UniversalScientificTechnologies/THUNDERMILL01/README.md

# THUNDERMILL01 - Electric field sensor

THUNDERMILL sensor mounted on Lomnický Štít observatory (https://www.youtube.com/watch?v=Zbx8tktlRBg)

THUNDERMILL01 is an open-source [Electric field mill](https://en.wikipedia.org/wiki/Field_mill) sensor for static, portable and airborne measurements. The device is equipped with open-source software that provides high flexibility from the point of view of data output. The sophisticated design of the sensor provides the ability to use the sensor for many applications. The sensor can be operated statically at a fixed location or on mobile measuring devices or may be mounted on unmanned aerial vehicles.

## Version for airborne measurements on board UAV

In the case of airborne measurements by UAV, the sensor is intended to be used with the [TF-ATMON](https://www.thunderfly.cz/tf-atmon.html) system. [TF-ATMON system](https://www.thunderfly.cz/tf-atmon.html) provides real-time data transmission to the ground station where it is visualized in a 3D map and provides the drone operator with a fast and flexible response to the measured data.

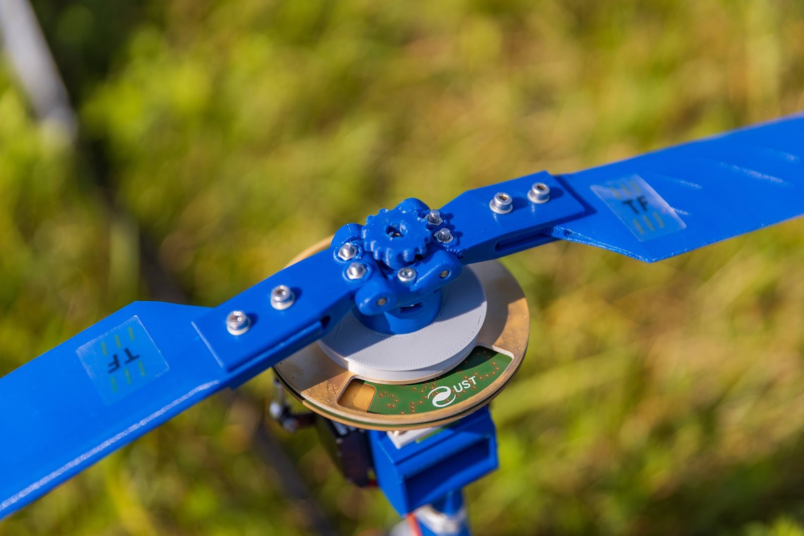
[picture p1: doc/img/THUNDERMILL01_UAV_TF-G2_rotor.jpg]
THUNDERMILL01A mounted to TF-G2 autogyro rotorhub


The sensor is commonly operated and equipped on the [ThunderFly TF-G2](https://github.com/ThunderFly-aerospace/TF-G2/) autogyro drone. In that case, the THUNDERMILL device is connected to on-board avionics as is displayed in the following diagram.  

THUNDERMILL01A diagram - part of TF-ATMON system

## Portable Version for car or stationary measurements

In the case of stationary or portable use, there exist rugged outdoor variants.

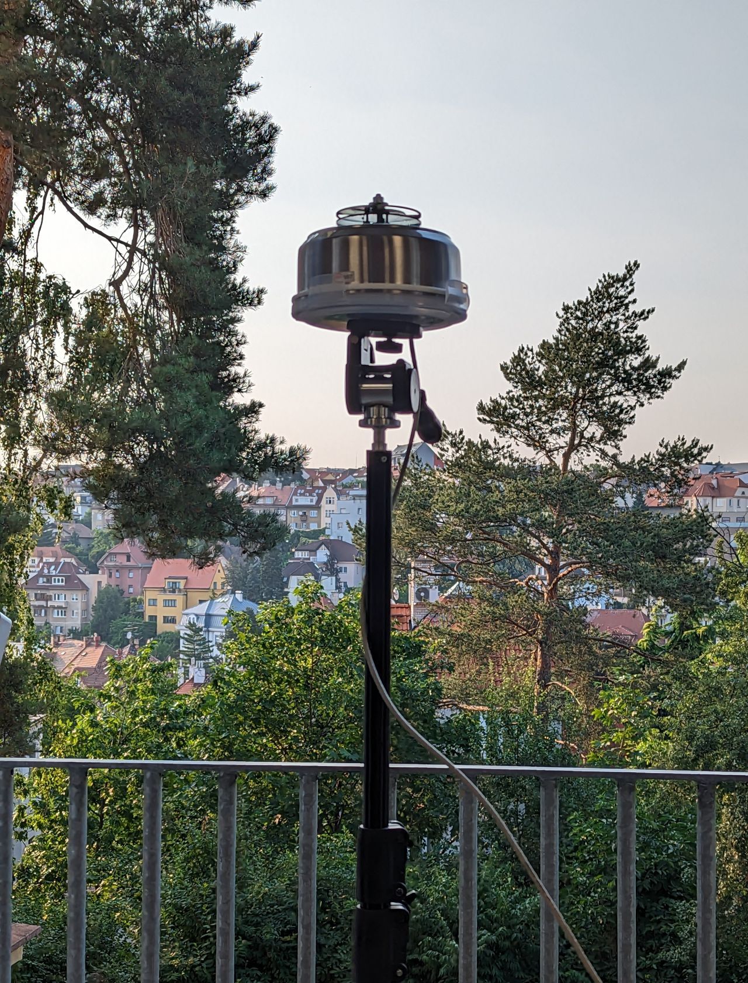
[picture p2: doc/img/THUNDERMILL01_stationary.jpg]
THUNDERMILL01B mounted on stationary platform


## Where to get it?

THUNDERMIL is commercially available as a customized solution from [Universal Scientific Technologies s.r.o.](https://www.ust.cz/), write an email to sale@ust.cz.
The device is designed as open-source hardware and software and is released under the GPLv3 license. 
The device was initially developed and maintained by [UST (Universal Scientific Technologies s.r.o.)](https://www.ust.cz) company, which sells it commercially and offers technical support.

## Relevant publications

  * [Measurements with Angular Sensitive Electric
Field Mill in Thunderstorms](https://iopscience.iop.org/article/10.1088/1742-6596/2985/1/012014/pdf)
