UniversalScientificTechnologies/THUNDERMILL01/doc/MCU_schematics.PDF

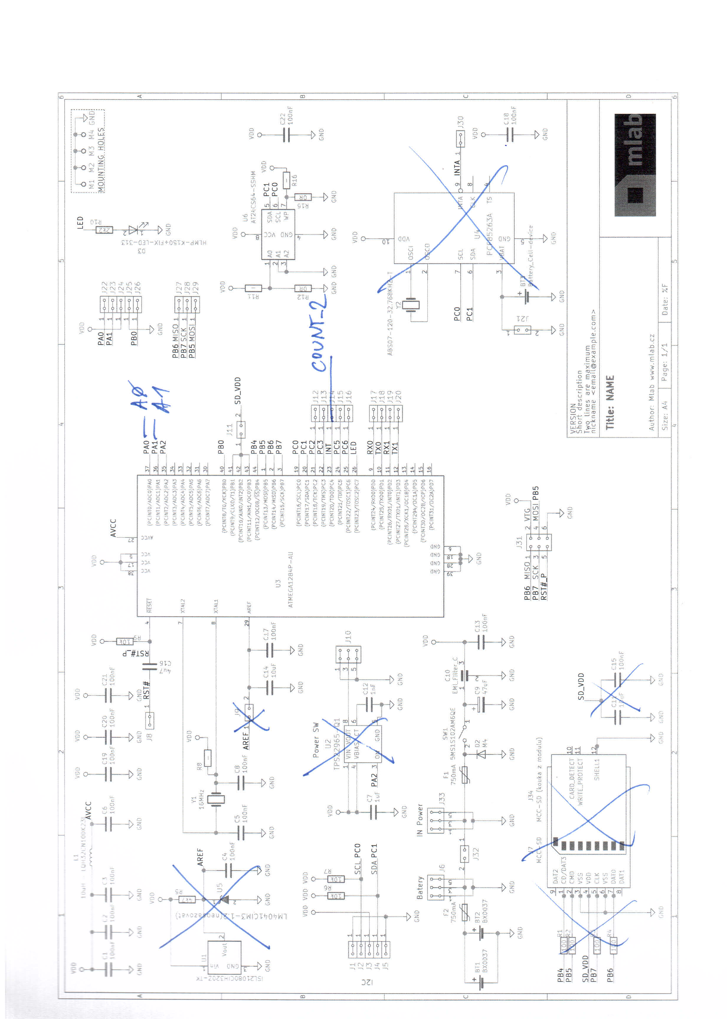
[picture p3: page 1]
