UniversalScientificTechnologies/THUNDERMILL01/doc/PCB_design.PDF

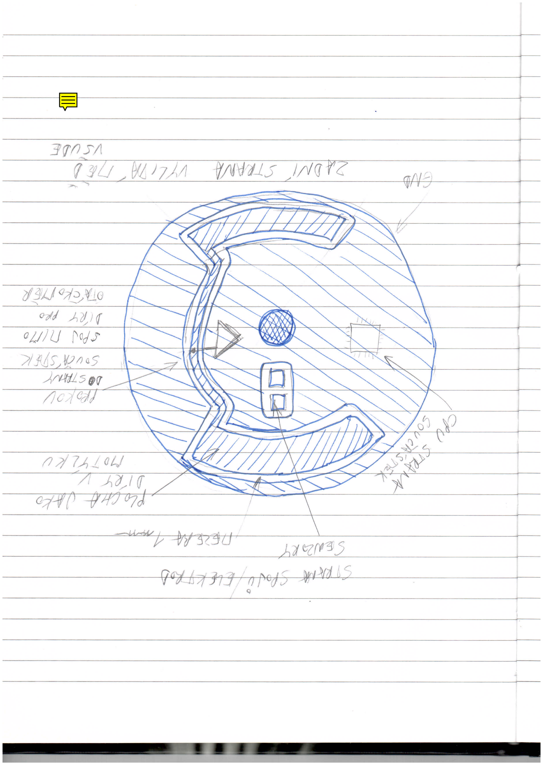
[picture p4: page 1]
