UniversalScientificTechnologies/THUNDERMILL01/doc/sensors.PDF

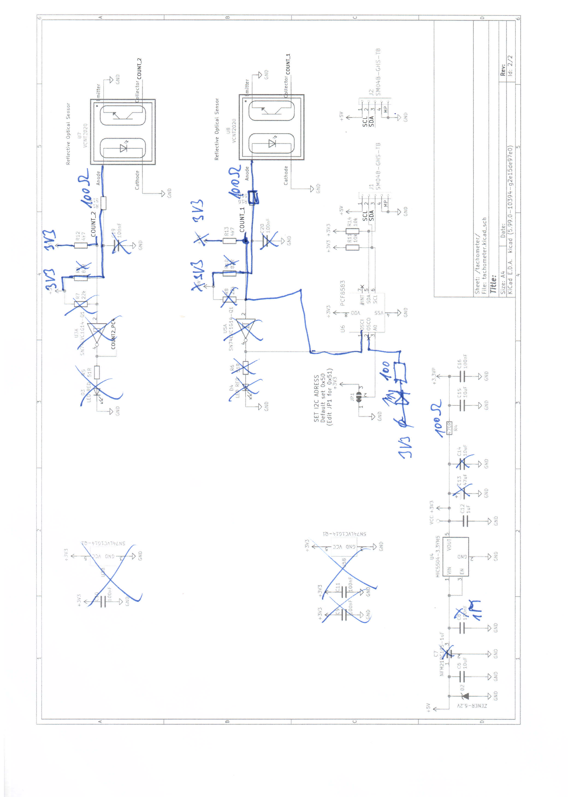
[picture p5: page 1]
