UniversalScientificTechnologies/THUNDERMILL01/doc/img/THUNDERMILL01_car_mount.jpg

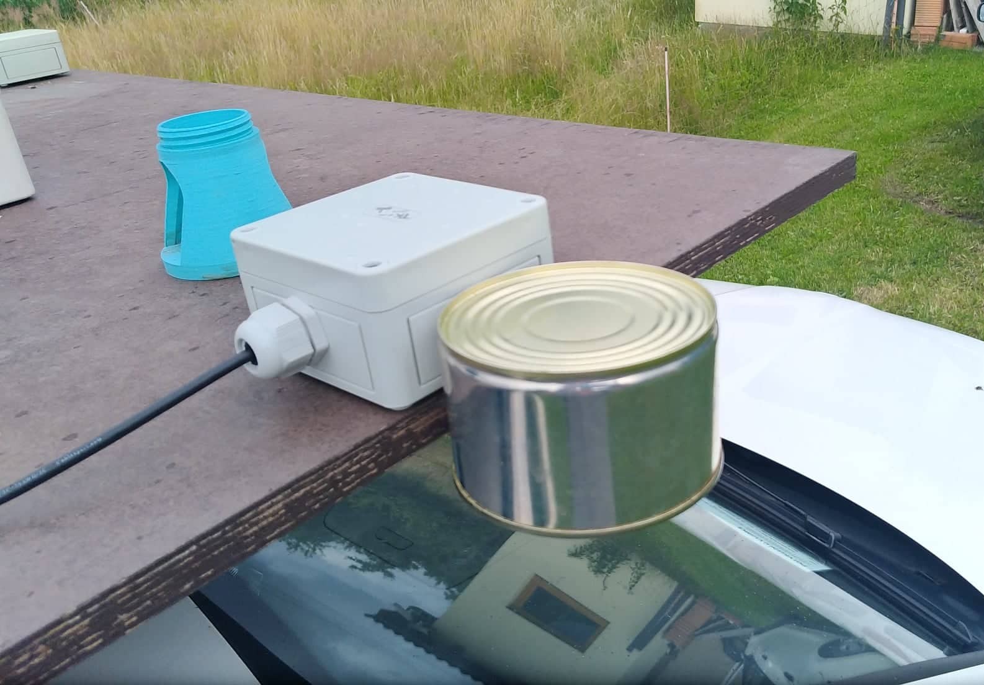
doc/img/THUNDERMILL01_car_mount.jpg
