UniversalScientificTechnologies/THUNDERMILL01/doc/img/THUNDERMILL01_directional_sensitivity.png

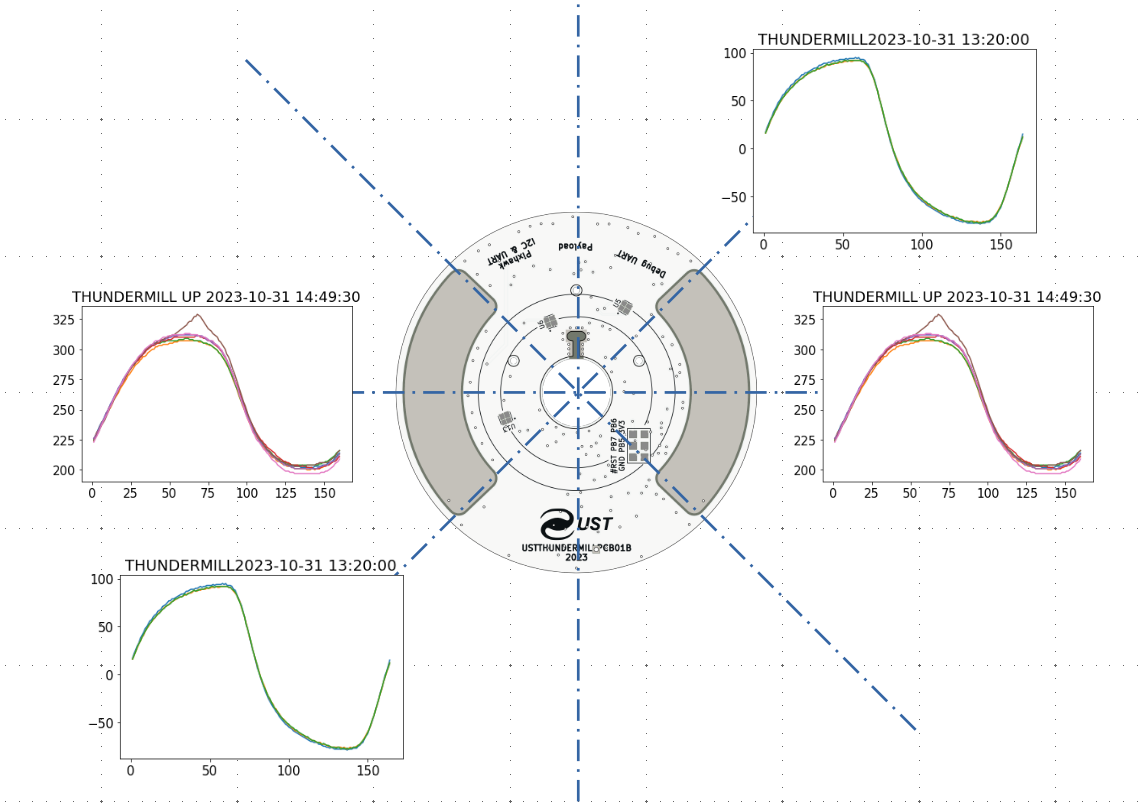
doc/img/THUNDERMILL01_directional_sensitivity.png
