UniversalScientificTechnologies/THUNDERMILL01/doc/img/THUNDERMILL01_stationary.png

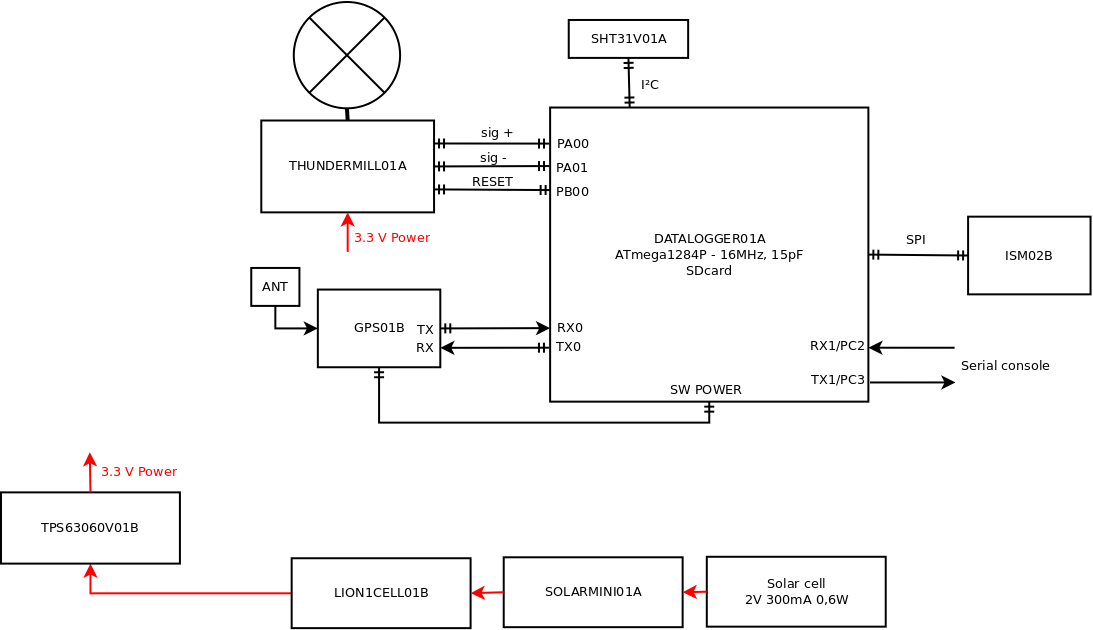
doc/img/THUNDERMILL01_stationary.png
