UniversalScientificTechnologies/THUNDERMILL01/doc/img/THUNDERMILL01_stationary_display.jpg

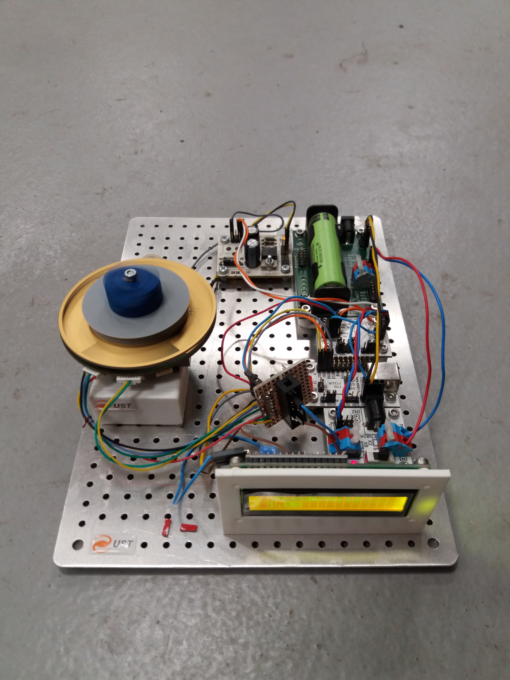
doc/img/THUNDERMILL01_stationary_display.jpg
