UniversalScientificTechnologies/THUNDERMILL01/(threads)

Thread 1 (2021-04-01):

Způsob měření vlhkosti a teploty

kaklik, 2021-04-01:
Pro správnou funkci mlýnku bude zřejmě potřeba měřit teplotu a vlhkost okolního vzduchu.
Nejlepší dostupné řešení zřejmě je data logovat pomocí autopilota a snímače [TFHT01](https://github.com/ThunderFly-aerospace/TFHT01)

Alternativně může být stejný snímač připojen do [obslužného MCU](https://github.com/UniversalScientificTechnologies/THUNDERMILL01/issues/4).

kaklik, 2021-04-01:
Pro případ vírníku TF-G2 bych navrhoval, tohle měření shovat do krytu dílu [TFSLOT](https://github.com/ThunderFly-aerospace/TFSLOT01), který bude součástí rotorového pylonu.

roman-dvorak, 2021-08-12:
Myslím, že pokud bude procesor na PCB mlýnku, tak je docela logické to umístit přimo na něj. Protože tak obslouží více věcí zároveň.

ChroustJan, 2021-08-13:
Kam by měl být ten senzor připojený? Do autopilota nebo toho procesoru mlýnku?

roman-dvorak, 2021-08-13:
Do procesoru mlýnku

kaklik, 2021-08-23:
Ve schéma je nyni zakreslen typ SHT31. Na rozdíl od SHT35, který má být používán v TFHT01.

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

Vzhledem k tomu, že tyto dva typy se liší pouze přesností měření. Jinak jsou funkčně i elektricky a mechanicky ekvivalentní, tak toto issue považuji za vyřešené.

Closed 2021-08-23.

Thread 3 (2021-04-01):

Návrh snímací elektroniky

kaklik, 2021-04-01:
Snímací elektrody z #2  budou potřebovat analogovou elektroniku pro zpracování signálu.
Tato elektronika by měla mít rozhraní vhodné k připojení k [obslužnému MCU](https://github.com/UniversalScientificTechnologies/THUNDERMILL01/issues/4).

Analogová elektronika by zřejmě měla být součástí měřících elektrod #2. Z té se pak vyvedou pouze signály potřebné pro připojení k obslužnému MCU #4 .

kaklik, 2021-07-22:
Zapojeni pro prototyp mlýnku

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

kaklik, 2021-08-15:
Zde jsou [doplňující požadavky na schéma](https://github.com/UniversalScientificTechnologies/THUNDERMILL01/blob/THUNDERMILL01A/doc/sensors.PDF) reflexivních snímačů.

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

roman-dvorak, 2021-08-15:
Před návrhem a výrobou je potřeba otestovat nové zapojení indikační LED u čítače o otáček s moduly TFRPM nebo s MLAB variantou modulu. Takovéto užití pinu není v datasheetu přímo uvedené.

kakl, 2021-08-16:
> Před návrhem a výrobou je potřeba otestovat nové zapojení indikační LED u čítače o otáček s moduly TFRPM nebo s MLAB variantou modulu. Takovéto užití pinu není v datasheetu přímo uvedené.

to se musi udelat po pripojeni k autopilotu po pnastaveni citace
pro me je to tezke nasimulovat

kaklik, 2021-08-16:
Signál na OSCO při otáčení současným kotoučkem THUNDERMILL. Snímač připojen k autopilotu ve vírníku, jeho inicializaci jsem neověřoval, ale předpokládám, že proběhla.  Očekával bych navíc, že invertor mezi OSCI a OSCO je zadrátován hardwarově.

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

Je tak asi potřeba jen zajistit, aby LED svítila viditelně intenzivně ze spodu kotoučku i za dne při nepřekročení těch 10mA, který ten výstup má ve specifikaci.

roman-dvorak, 2021-08-16:
Požadavky na přípojní elektroniky:

- [ ] JST-GH konektor pro I2C z čítače otáček do autopilota (Donecode I2C port)
- [ ] JST-GH UART konektor pro přípojení MCU do autopilota (Dronecode telemetry port)
- [ ] JST-GH konektor jako vývod analogového signálu z mlýnku
- [ ] Ploška pro připájení vodiče z rotačního disku
- [ ] Ploška pro připájení vodiče ze spodní elektrody
- [ ] JST-GH konektor pro připojení TFPAYLOAD konektoru z GPS (TF zapojení)
  - [ ] PPS signál do MCU
  - [ ] RX/TX na druhý UART MCU
  - Co s I2C z GPS? Nechat ho odpojený? nebo je potřeba ho zapojit do MCU
- [ ] LED pro signalizaci funkce RPM senzoru (z PCF8583)
- [ ] LED pro signalizaci funkce MCU

kaklik, 2021-08-18:
Transil bych navrhoval použít tenhle: https://www.tme.eu/cz/details/uclamp3312t.tct/transil-diody-obousmerne-smd/semtech/
Není asi úplně praktický že je dvojitej, ale při jeho velikosti by to asi nemělo vadit.

ChroustJan, 2021-08-19:
@kaklik nemohl by jsi prosím najít jiný třeba u jiného dodavatele? S nějakým normálním pouzdrem? Tento jsem našel taky, ale zavrhl.

ChroustJan, 2021-08-22:
Využit tento transil: UCLAMP3301H.TCT

kaklik, 2021-08-23:
Ve schématu je špatně, že je tam značka bipolárního transilu a ve skutečnosti je použit unipolární.

kaklik, 2021-08-23:
>
>  Co s I2C z GPS? Nechat ho odpojený? nebo je potřeba ho zapojit do MCU
>

V případě použití čtyřvrstvého plošného spoje podle mě nění důvod tyto piny na PAYLOAD konektoru nezapojovat.  I2C na tomto konektoru bych ale navrhoval zapojit přes 100ohm rezistory, neboť potřebujeme, aby primárně fungovalo čidlo a paměť přímo na mlýnku. Použití I2C rozhraní GPS je option.

Zbylé piny z payload konektoru, jsou EXTINT, GEO_STAT, SDA, SCL.  Všechny se kromě I2C mohou připojit na libovolné piny MCU.

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

ChroustJan, 2021-08-23:
@kaklik tak tedy takto? https://github.com/UniversalScientificTechnologies/USTTHUNDERMILLPCB01/blob/USTTHUNDERMILLPCB01A/hw/sch_pcb/USTTHUNDERMILLPCB01A/USTTHUNDERMILLPCB01A.pdf

kaklik, 2021-08-23:
Moje poznámka je v aktuální verzi vyřešena.

Closed 2021-08-23.

Thread 4 (2021-04-01):

Obslužný mikrokontroler

kaklik, 2021-04-01:
Celé zařízení by mělo být senzorem systému [TF-ATMON](https://www.thunderfly.cz/tf-atmon.html), který předpokládá připojení snímačů přes MCU desku [TFUNIPAYLOAD01](https://github.com/ThunderFly-aerospace/TFUNIPAYLOAD01). Snímací elektronika #3 by se tak měla připojovat k této MCU desce.

kaklik, 2021-04-01:
Zatím to lze testovat na [DATALOGGER01](https://github.com/mlab-modules/DATALOGGER01).

kaklik, 2021-07-25:
Alternativní možnosti realizace jsou:

## Přidání MCU přímo na snímací statický kotouček

Ze spodní strany je na snímacím kotoučku pravděpodobně dost místa na to, aby zde mohl být umístěn i MCU z TFUNIPAYLOAD.

## Vzorkování signálu MCU z autopilota

Takový postup by vyžadoval zakódovat nulovou pozici do analogového signálu.  Výhodou by bylo, že
  1. nemusíme mít hned nakreslený TFUNIPAYLOAD.
  2. Ušetříme hmotnost.
  3. Nebude potíž se synchronizací dat k ostatním datům z autopilota, protože to může celé logovat rovnou autopilot. Ten určitě umí logovat ADC 100Hz viz https://px4.github.io/Firmware-Doxygen/d6/dec/class_a_d_c.html#a234ca7690a8648d6a1db818b0cf4d816  Možná by to ale mohlo jít nastavit i na rychlejší hodnotu, pokud je to potřeba.

Autopilot má [dva ADC kanály na jednom konektoru na kterém je k dispozici i 5V napájení.](https://raw.githubusercontent.com/cuav/hardware/master/V5_Autopilot/V5_NANO/RC03/V5_NANO_RC03.pdf)

Překážkou k realizace této metody je, že nevíme, zda ADC autopilota umí vzorkovat 1MSPS, který se aktuálně používá v testovacím prototypu mlýnku.

Nicméně by asi bylo vhodné, aby snímací elektronika #3 Umožňovala obě tyto možnosti připojení. Což se ale bude hodit i kvůli diagnostickým účelům.

kaklik, 2021-08-13:
@kakl  je zřejmě potřeba pro @ChroustJan  připravit schéma zapojení včetně MCU.  Což zřejmě znamená vytisknout a proškrtat zapojení [DATALOGGER01](https://github.com/mlab-modules/DATALOGGER01).

kaklik, 2021-08-15:
Zde je [scan proškrtaného schéma](https://github.com/UniversalScientificTechnologies/THUNDERMILL01/blob/THUNDERMILL01A/doc/MCU_schematics.PDF) DATALOGGER01.

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

kaklik, 2021-08-18:
K MCU je vhodné použít například [tento krystal](https://www.tme.eu/cz/details/16.00m-cfpx-218/krystalove-rezonatory-smd/iqd-frequency-products/lfxtal069392cutt/). Zároveň je však nutné opravit chybu https://github.com/mlab-modules/DATALOGGER01/issues/1

ChroustJan, 2021-08-19:
Je použitelný pro kapacity v tomto pásmu?
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

kaklik, 2021-08-19:
> Je použitelný pro kapacity v tomto pásmu?
> 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

Neuvědomuji si žádný důvod proč by nebyl.

ChroustJan, 2021-08-20:
Bude použit tento krystal: https://www.tme.eu/cz/details/16.00m-cfpx180/krystalove-rezonatory-smd/iqd-frequency-products/lfxtal035264reel/

kaklik, 2021-08-20:
> Bude použit tento krystal: https://www.tme.eu/cz/details/16.00m-cfpx180/krystalove-rezonatory-smd/iqd-frequency-products/lfxtal035264reel/

Jeho alternativní typ pro 20MHz je [tento](https://www.tme.eu/cz/details/20.00m-cfpx180/krystalove-rezonatory-smd/iqd-frequency-products/lfxtal035265reel/).

kaklik, 2021-08-23:
Úkoly z tohoto issue jsou implementovány a oba krystaly přesunuty do nákupního seznamu.

Closed 2021-08-23.

Thread 5 (2021-08-12):

Generation of Kicad edge layer and copper layout from OpenSCAD

kaklik, 2021-08-12:
Aby bylo možné vyrobit desku, která bude vycházet z OpenSCAD návrhu, je potřeba dodržet následující postup. Je potřeba, abyste se @ChroustJan a @Alsa-Tucnak dohodli, kde kterou část udělá. Já bych navrhoval, aby @Alsa-Tucnak  končila vygenerováním SVG stop.

# Kroky:

- [x] Namodelování prototypu v OpenSCADU - @Alsa-Tucnak
- [x] Otestování vytištěných disků (sestavení) - @Alsa-Tucnak
- [x] Export dat pro import do kicadu - Frézování  - @Alsa-Tucnak
- [x] Export dat pro import do kicadu - Měděná vrstva  - @Alsa-Tucnak
- [x] Export dat pro import do kicadu - Vrtané otvory - @Alsa-Tucnak
- [x] Import všech dílčích dat do Kicadu - @ChroustJan
- [ ] Dokončení PCB (schéma, layout) - @ChroustJan

**Při všech importech do kicadu je potřeba importovat na určité souřadnice (screenshoty toto pravidlo nereflektují)**

## Postup

### Namodelování v OpenSCADu

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

Vytvoření řezu
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

Uložit jako svg:
Soubor -> Exportovat -> Exportovat jako SVG

Postup je potřeba opakovat pro všechny vrstvy. Tj. Obrys, měď, atd..

### Import do KiCADu

Otevřít Kicad - PCBnew
Vybrat ořezovou vrstvu
Soubor -> Import -> Grafika

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

Zde je potřeba vybrat správný soubor, Vybrat vrstvu pro frézavání (edge.Cuts), měřítka 1,0. Ideální je umístit SVG na určité souřadnice výkresu. Protože na stejné souřadnice se budou vkládat další modely.

Následně disk umístit do prostoru

V 3D náhledu bychom měli vidět toto:
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

Pokud bude potřeba definovat i plochu výplně, tak to se musí vytvořit vlastní openscad modul obsahujíci plochu měděné výplně˙
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

A tento objekt se chová jako měděná výplň. To se může hodit na přesné namodelování prostorů elektrod.

Otvory pro vrtání
Nevím o přímé cestě, jak vložit do kicadu otvorp pro vrtání. Je tedy nutné si pomoct tak, že v OpenSCADu se vygeneruji pomocné značky pro místa vrtání. To se naimportuje do kicadu, do nějaké uživatelské vrstvy. A v Kicadu se na tato místa vloží vrtané díry.

[Zde jsem našel pána na youtube](https://youtu.be/hHURDpH471o?t=194), který má trik na to, jak díry v DXF zarovnat s footprinty děr tak, aby se ten střed nemusel hledat ručně.

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

V kicadu následně umístit díry jako footprint:
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

kaklik, 2021-08-17:
@Alsa-Tucnak  dnes vygenerovala [svg exporty](https://github.com/ThunderFly-aerospace/TF-G2/tree/THUNDERMILL01/CAD/svg). Takže teď je na @ChroustJan  aby vyzkoušel jejich import do KiCADu.

kaklik, 2021-08-23:
Tvar PCB je stabilizován od soboty.

Closed 2021-08-23.

Thread 7 (2021-08-19):

Vodivé spojení rotoru a statoru

roman-dvorak, 2021-08-19:
Pro správnou funkci mlýnku je potřeba vodivě spojit rotor se statorem. Rotor bude celý pokovený bez masky, takže na něj lze vodič připájet kamkoliv. Předpokládá se připojení na vrchní stranu. Vodič ale nesmí bránit roztáčení rotoru pomocí stuhy, nesmí se plést do kódovacích otvorů a nesmí se dřit o statickou část sloupku okolo osy rotoru.

V případě statoru je situace jiná. Spojení s rotorem musí být přivedeno ze spodní strany a na nerotující osu rotoru. Takovým bodem je například ložisko rotoru. Pod něj je možné přimáčknout drátek. Do tištěného sloupku je potřeba vymodelovat drážku, ve které bude lanko umístěné. Drážka by měla být trochu zahnutá i přes hranu ložiska. Tedy do mostu nad ložiskem.

kaklik, 2021-08-20:
## Stator

Navrhoval bych pro připojení statoru na ložisko využít [tenhle pin](https://www.tme.eu/cz/details/365.35.40.40/zkusebni-hroty/fixtest/).
Je bohužel poměrně tlustý - průměr pinu je 4mm a tělo pinu má průměr 5mm.
Proto bych navrhoval do statoru udělat drážku, třeba o šířce 3mm  s tím že tento pin se do ní "položí" a zaletuje z bočních stran a následně z druhé strany.
Délka drážky by měla být 9-10mm.   Protože bude frézovaná, tak by opět měla mít okraje s radiusem.

kaklik, 2021-08-21:
### Rotor

Na rotoru bych navrhoval lanko z kotoučku vodivě připojit ke šroubu pomocí [pájecícího očka M3](https://www.gme.cz/kabelove-ocko-rl04470) a [rýhované matice M3](https://eshop.killich.cz/eshop/matice-m3-zinek-4-ryhovana-din-466_14612503.html).

Výsledkem pak je takového spojení:

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

Je tak ještě potřeba:

- [ ] Vytvořit průchod pro vodič stínícím kotoučkem
- [ ] Vytvořit průchod skrz stěnu rolničky rotoru.

kaklik, 2021-08-31:
Zbývá řešení vyzkoušet, jinak je všechno připraveno.

Thread 11 (2022-03-16):

Měření horizontálního elektrického pole

kaklik, 2022-03-16:
Vzhledem k posledním poznatkům od @kakl  kde to vypadá, že je nutné prokázat elektrické pole v horizontální rovině. To vypadá, že je nutné mlýnek rozšířit o měření horizontální složky pole.

V případě montáže na [TF-G2](https://github.com/ThunderFly-aerospace/TF-G2) by to asi bylo možné zajistit  přidáním elektrod na konce rotorových listů.
V takovém případě by se rotační kotouček musel rozšířit o elektroniku, která by signál z rotačních elektrod na listech zpracovávala.

Technickým problémem je pak přivedení takového signálu z rotačních částí do elektroniky autopilota za účelem přenosu telemetrií a záznamu.

kakl, 2022-03-16:
to by pak nemusely byt dva kotoucky, protoze by se stridala na koncich rotoru polarita pole
kdyby byla v rotoru baterka, mohlo by to hodnoty vysilat

roman-dvorak, 2022-03-17:
Napájení do rotoru by se myslím dalo vyřešit tak, aby na rotor stačilo umístit pouze nějaký větší kondenzátor.

kaklik, 2022-03-17:
> Napájení do rotoru by se myslím dalo vyřešit tak, aby na rotor stačilo umístit pouze nějaký větší kondenzátor.

To je myslím zrovna lepší udělat nějakou knoflíkovou baterkou.  Horší je to ale s tím bezdrátovým přenosem.  Blbý je, že nemůžu najít RF obvod, který by udělal seriovou linku třeba na dva metry.

roman-dvorak, 2022-03-17:
IRDA? :D

kakl, 2022-03-17:
co dynamo?
respektive alternator s permanentnim magnetem

jestli se na IRDA jeste delaji vysilace, to jsem uz dlouho nevidel pouzity

kakl, 2022-03-17:
jo, stale se to vyrabi kvuli elektromerum

kaklik, 2022-03-17:
IRDA je ale děsně směrová, ne?  (Je to vymyšlený jako zabezpečený komunikační kanál)   Lze nějak zařídit, aby z rotujícího rotoru to přeneslo data někam na vírník?

Thread 14 (2024-06-16):

PCB motor for static variant of THUNDERMILL

kaklik, 2024-06-16:
Pro variantu mlýnku, která má být staticky umístěná by možná byl vhodnější [PCB motor](https://github.com/cooked/kimotor).

Taková konstrukční změna by mohla zmírnit následující potíže:

- Současný motor je velmi symetrický, takže nefunguje dobře měření fáze rotoru. Kdyby se PCB motoru trochu změnily cívky, tak aby byly dostatečně nezáměné během otáčky, tak by nemuselo být nutné pouzívat extra čidlo na  zjištění fáze.
- Motor na PCB by zřejmě mohl být velmi odolný jak mechanicky tak i proti vodě a korozi. Navíc může být pak celý umístěn mimo krabici s elektronikou.
