UniversalScientificTechnologies/THUNDERMILL01/(commit log)

2021-04-01 Add sensor for temperature and relative humidity. Add LoRa modem.
2021-08-23 Adding rotor PCB desig.
2021-08-23 Renaming rotor design directory
    [USTTHUNDERMILLPCB02A.kicad_pcb, USTTHUNDERMILLPCB02A.kicad_sch]
2021-08-23 Add dimensions to PCB and improve readme.
    [USTTHUNDERMILLPCB02A-B_Cu.gbr, USTTHUNDERMILLPCB02A-B_Mask.gbr, USTTHUNDERMILLPCB02A-Edge_Cuts.gbr, USTTHUNDERMILLPCB02A-Edge_Mill.gbr, USTTHUNDERMILLPCB02A-F_Cu.gbr, USTTHUNDERMILLPCB02A-F_Mask.gbr, USTTHUNDERMILLPCB02A-User_Comments.gbr, USTTHUNDERMILLPCB02A-User_Drawings.gbr]
2021-08-23 Removing accidentally commited files directly in repository instead of submodule.
    [USTTHUNDERMILLPCB02A-B_Cu.gbr, USTTHUNDERMILLPCB02A-B_Mask.gbr, USTTHUNDERMILLPCB02A-Edge_Cuts.gbr, USTTHUNDERMILLPCB02A-Edge_Mill.gbr, USTTHUNDERMILLPCB02A-F_Cu.gbr, USTTHUNDERMILLPCB02A-F_Mask.gbr, USTTHUNDERMILLPCB02A-User_Comments.gbr, USTTHUNDERMILLPCB02A-User_Drawings.gbr]
2021-08-23 Add rotor PCB as submodule.
2021-10-18 Add new images of THUNDERMILL prototype.
2022-10-11 Add photo of car roof mount.
2023-12-26 Update README.md
    Add gif preview of the mounted sensor.
2024-05-24 Add the link to used hardware BLDC driver.
2026-04-19 Update block schematics.
